Rutu-Raaj/Smart_Medicine_Alarm/(commit log)

2026-11-11 Add ESP32 firmware, desktop dashboard, and README
    - firmware/SmartMedicineAlarm: Wi-Fi access point firmware with JSON
    API, built-in web dashboard, IR-confirmed buzzer alarm, smooth servo
    - dashboard: CustomTkinter desktop dashboard with pill-tray view
    - README with hardware, wiring, setup, API, and known limitations
    [SmartMedicineAlarm.ino]
2026-11-11 Add circuit schematic to docs and README
    Full schematic of the ESP32, servo, buzzer, IR sensor, I2C LCD and
    5 V supply, with pin map, parts list and wiring notes.
2026-11-12 Fix early re-firing alarm and IR stop logic; move buzzer and servo pins
    - Saving a schedule now changes only the dose times. Doses already
    given today stay given, so a dose is never dispensed twice and the
    servo stays in step with the slot count.
    - Reset no longer clears the same-minute trigger guard, so a dose does
    not fire again immediately after a reset during its own minute.
    - IR readings are debounced (IR_STABLE_MS) and ignored while the disk
    is turning, so sensor flicker no longer stops the alarm instantly.
    - Status API and both dashboards show the live tablet sensor reading.
    - A brownout reset is reported on the LCD and serial output.
    - Buzzer moved from GPIO 18 to GPIO 33, se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
    [SmartMedicineAlarm.ino]
2026-11-12 Add full project documentation PDF
    docs/Smart_Medicine_Alarm_Documentation.pdf covers hardware, wiring,
    firmware logic with diagrams, dashboards, device API, setup, daily use,
    configuration, troubleshooting and the change log. README links to it.
